tjbraham/modular-open-source-ptz-ai-cam-stack/Vision/Enclosure/Enclosure-assembled.stl

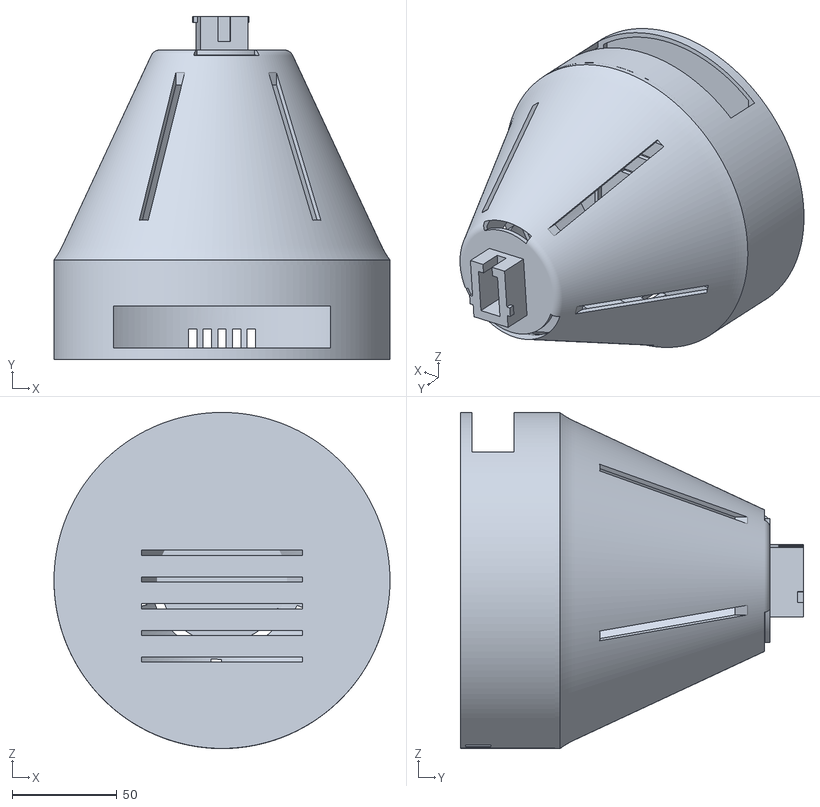
[picture p1: CAD file, 2026-06-19]
Vision/Enclosure/Enclosure-assembled.stl
160.0 x 163.5 x 160.1
