tjbraham/modular-open-source-ptz-ai-cam-stack/Power/Power_stack_PCB_stl/new_base.stl

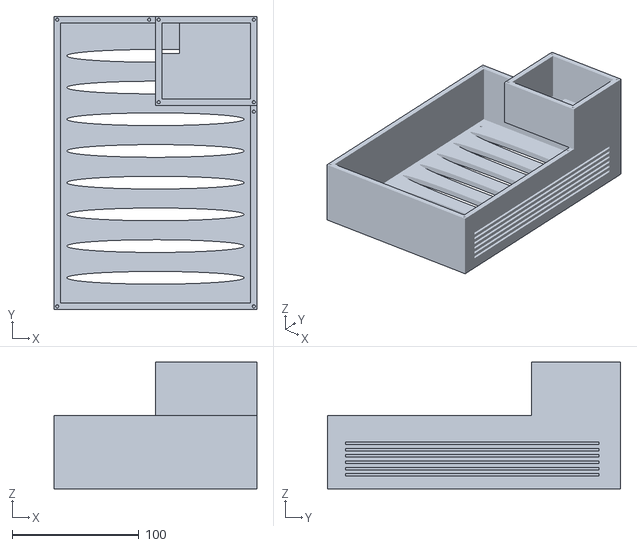
[picture p2: CAD file, 2026-06-20]
Power/Power_stack_PCB_stl/new_base.stl
160.0 x 231.0 x 100.0
