tjbraham/modular-open-source-ptz-ai-cam-stack/Vision/Motor-Brackets/Bottom-Bracket-Pan/Bottom-Bracket-Part-1.stl

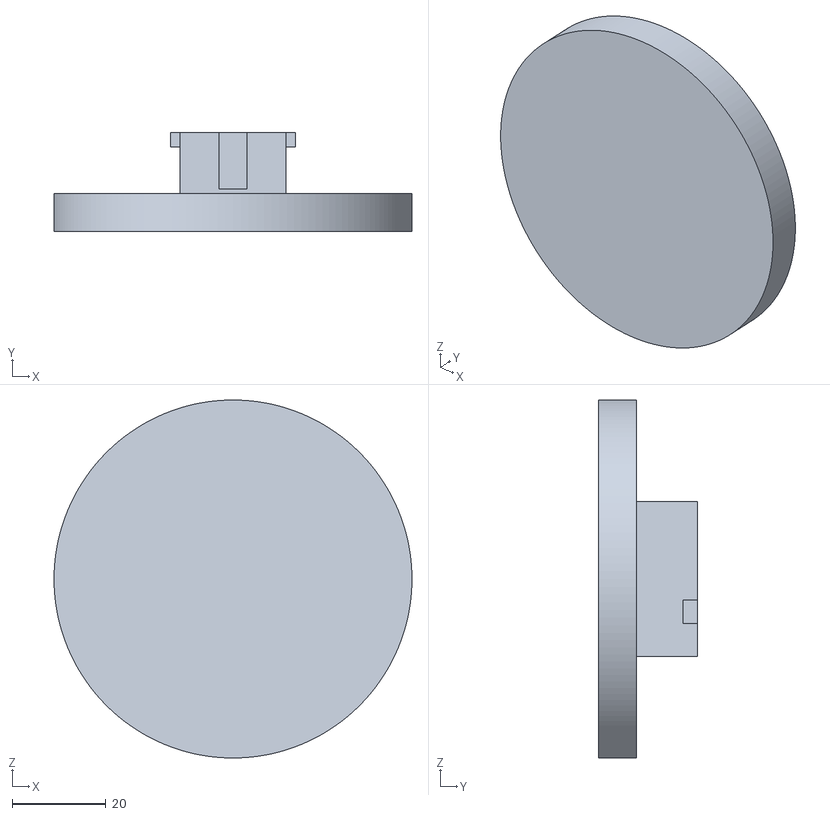
[picture p3: CAD file, 2026-06-19]
Vision/Motor-Brackets/Bottom-Bracket-Pan/Bottom-Bracket-Part-1.stl
76.2 x 21.0 x 76.2
