tjbraham/modular-open-source-ptz-ai-cam-stack/Vision/Motor-Brackets/Top-Bracket-Tilt/Top-Bracket-Part-1.stl

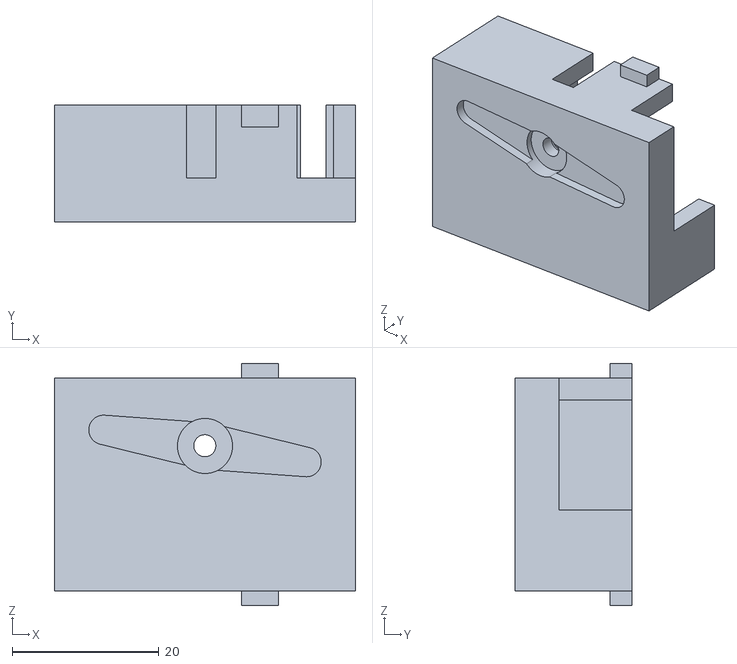
[picture p4: CAD file, 2026-06-19]
Vision/Motor-Brackets/Top-Bracket-Tilt/Top-Bracket-Part-1.stl
41.0 x 15.9 x 33.0
