tjbraham/modular-open-source-ptz-ai-cam-stack/Power/Power_stack_PCB_stl/PCB_holder_topSm.3mf

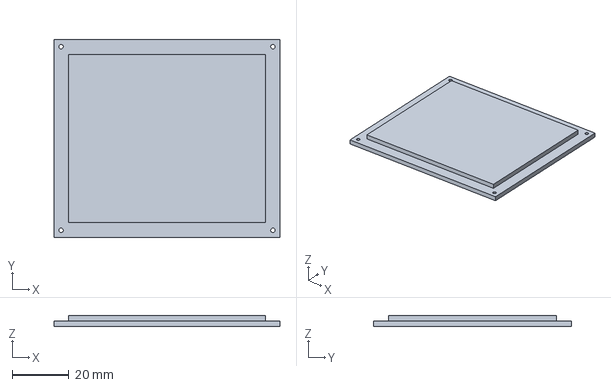
[picture p5: CAD file, 2026-06-20]
Power/Power_stack_PCB_stl/PCB_holder_topSm.3mf
80.0 x 70.0 x 4.00 mm
