tjbraham/modular-open-source-ptz-ai-cam-stack/Vision/Enclosure/Lid-enclosure.stl

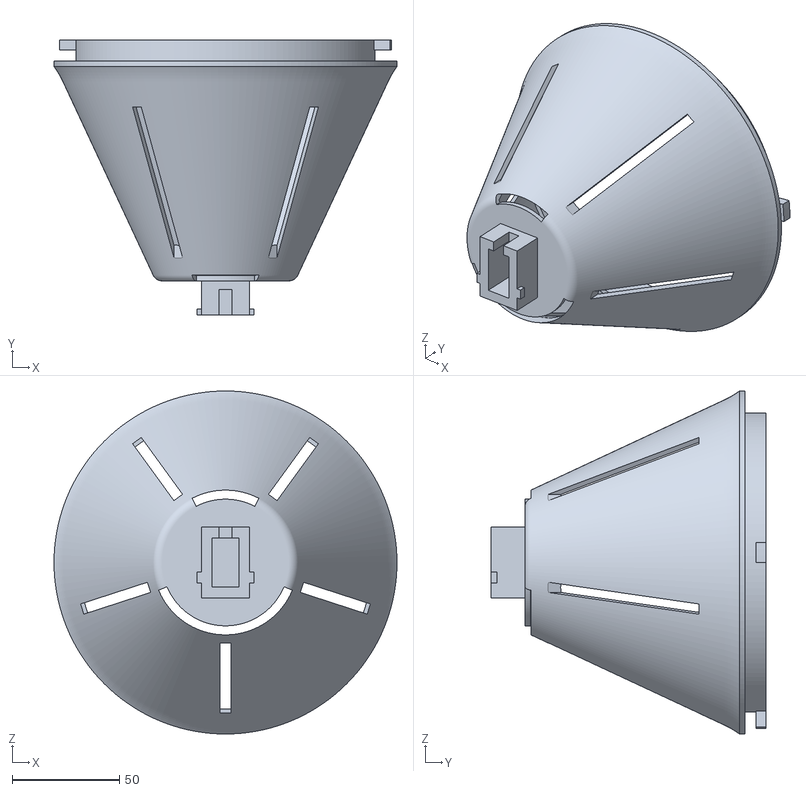
[picture p6: CAD file, 2026-06-19]
Vision/Enclosure/Lid-enclosure.stl
160.0 x 128.5 x 160.0
