tjbraham/modular-open-source-ptz-ai-cam-stack/Vision/Motor-Brackets/Bottom-Bracket-Pan/Bottom-Bracket-Part-2.stl

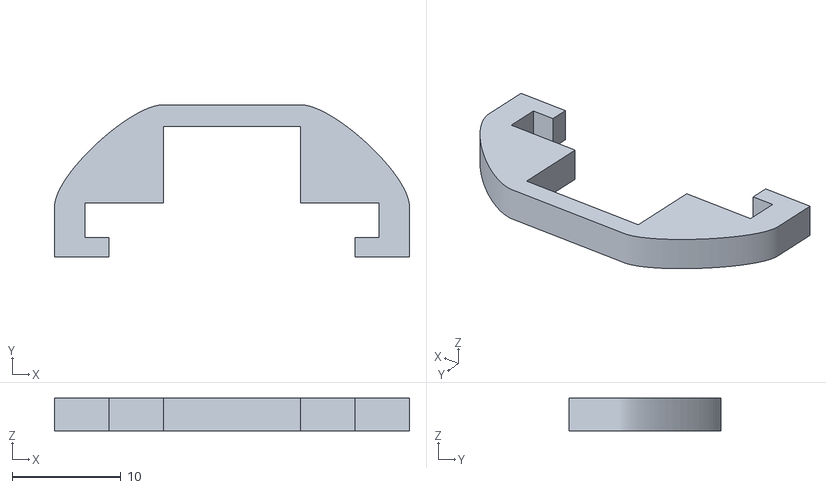
[picture p7: CAD file, 2026-06-19]
Vision/Motor-Brackets/Bottom-Bracket-Pan/Bottom-Bracket-Part-2.stl
32.6 x 14.0 x 3.00
