tjbraham/modular-open-source-ptz-ai-cam-stack/Vision/Motor-Brackets/Top-Bracket-Tilt/Top-Bracket-Part-2.stl

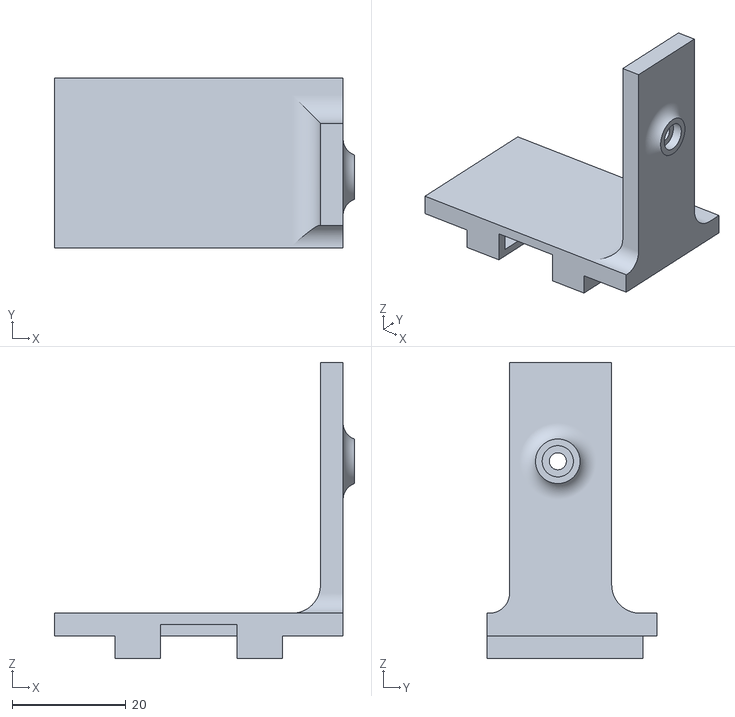
[picture p8: CAD file, 2026-06-19]
Vision/Motor-Brackets/Top-Bracket-Tilt/Top-Bracket-Part-2.stl
52.8 x 30.0 x 52.2
