tjbraham/modular-open-source-ptz-ai-cam-stack/Power/Power_stack_PCB_stl/new_PCB_holder_topL.3mf

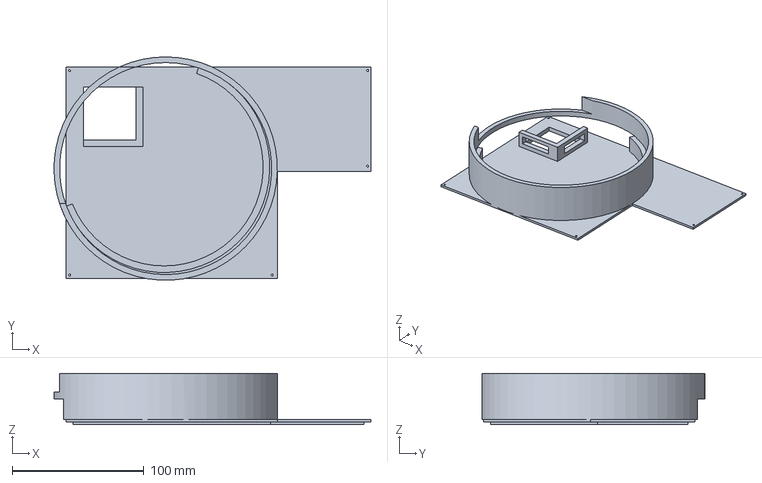
[picture p9: CAD file, 2026-06-20]
Power/Power_stack_PCB_stl/new_PCB_holder_topL.3mf
240.3 x 169.2 x 39.0 mm
