tjbraham/modular-open-source-ptz-ai-cam-stack/Vision/Enclosure/Bottom-enclosure.stl

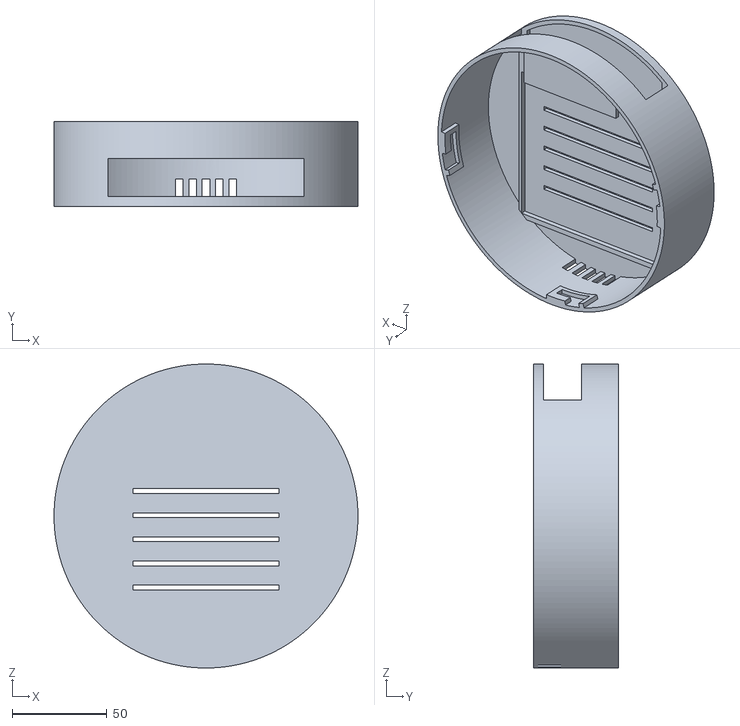
[picture p10: CAD file, 2026-06-19]
Vision/Enclosure/Bottom-enclosure.stl
160.0 x 45.0 x 160.0
