tjbraham/modular-open-source-ptz-ai-cam-stack/Vision/Motor-Brackets/Top-Bracket-Tilt/Top-Bracket-Part-3.stl

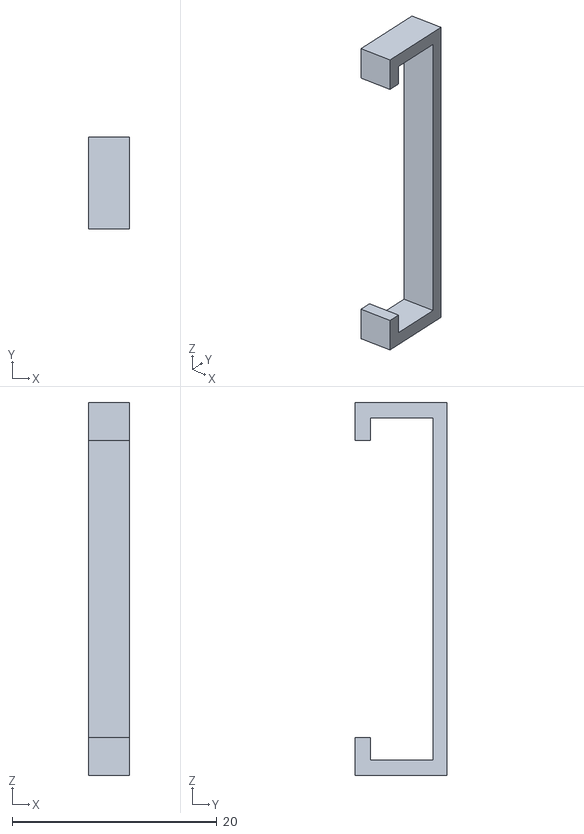
[picture p11: CAD file, 2026-06-19]
Vision/Motor-Brackets/Top-Bracket-Tilt/Top-Bracket-Part-3.stl
4.00 x 9.00 x 36.4
