tjbraham/modular-open-source-ptz-ai-cam-stack/Power/Power_stack_PCB_stl/PCB_holder_base.3mf

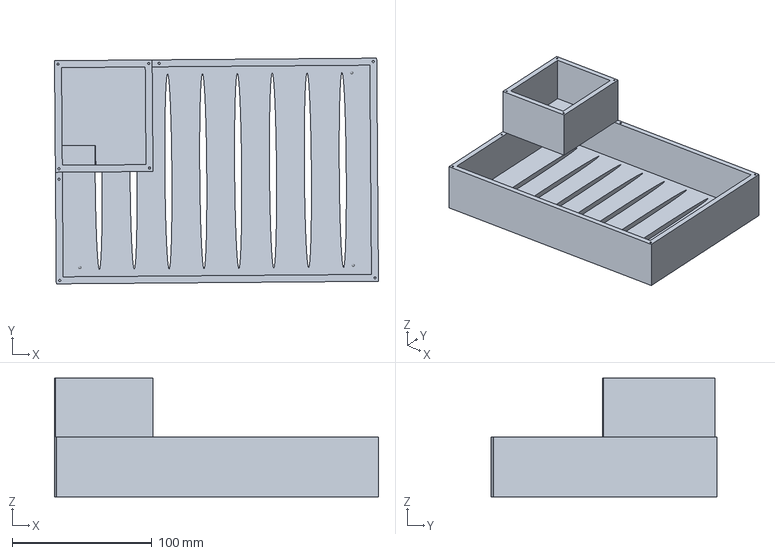
[picture p12: CAD file, 2026-06-20]
Power/Power_stack_PCB_stl/PCB_holder_base.3mf
232.3 x 161.8 x 85.0 mm
