tjbraham/modular-open-source-ptz-ai-cam-stack/(list of files, cad)

Other CAD files:
Power/Power_stack_PCB_stl/PCB_holder_base.stl
Power/Power_stack_PCB_stl/PCB_holder_topSm.stl
Power/Power_stack_PCB_stl/new_PCB_holder_topL.stl
