tjbraham/modular-open-source-ptz-ai-cam-stack/Power/PCB_files/GA8ED_Capstone_revised.kicad_pcb

## KiCad design Power/PCB_files/GA8ED_Capstone_revised.kicad_pcb (2026-06-20)

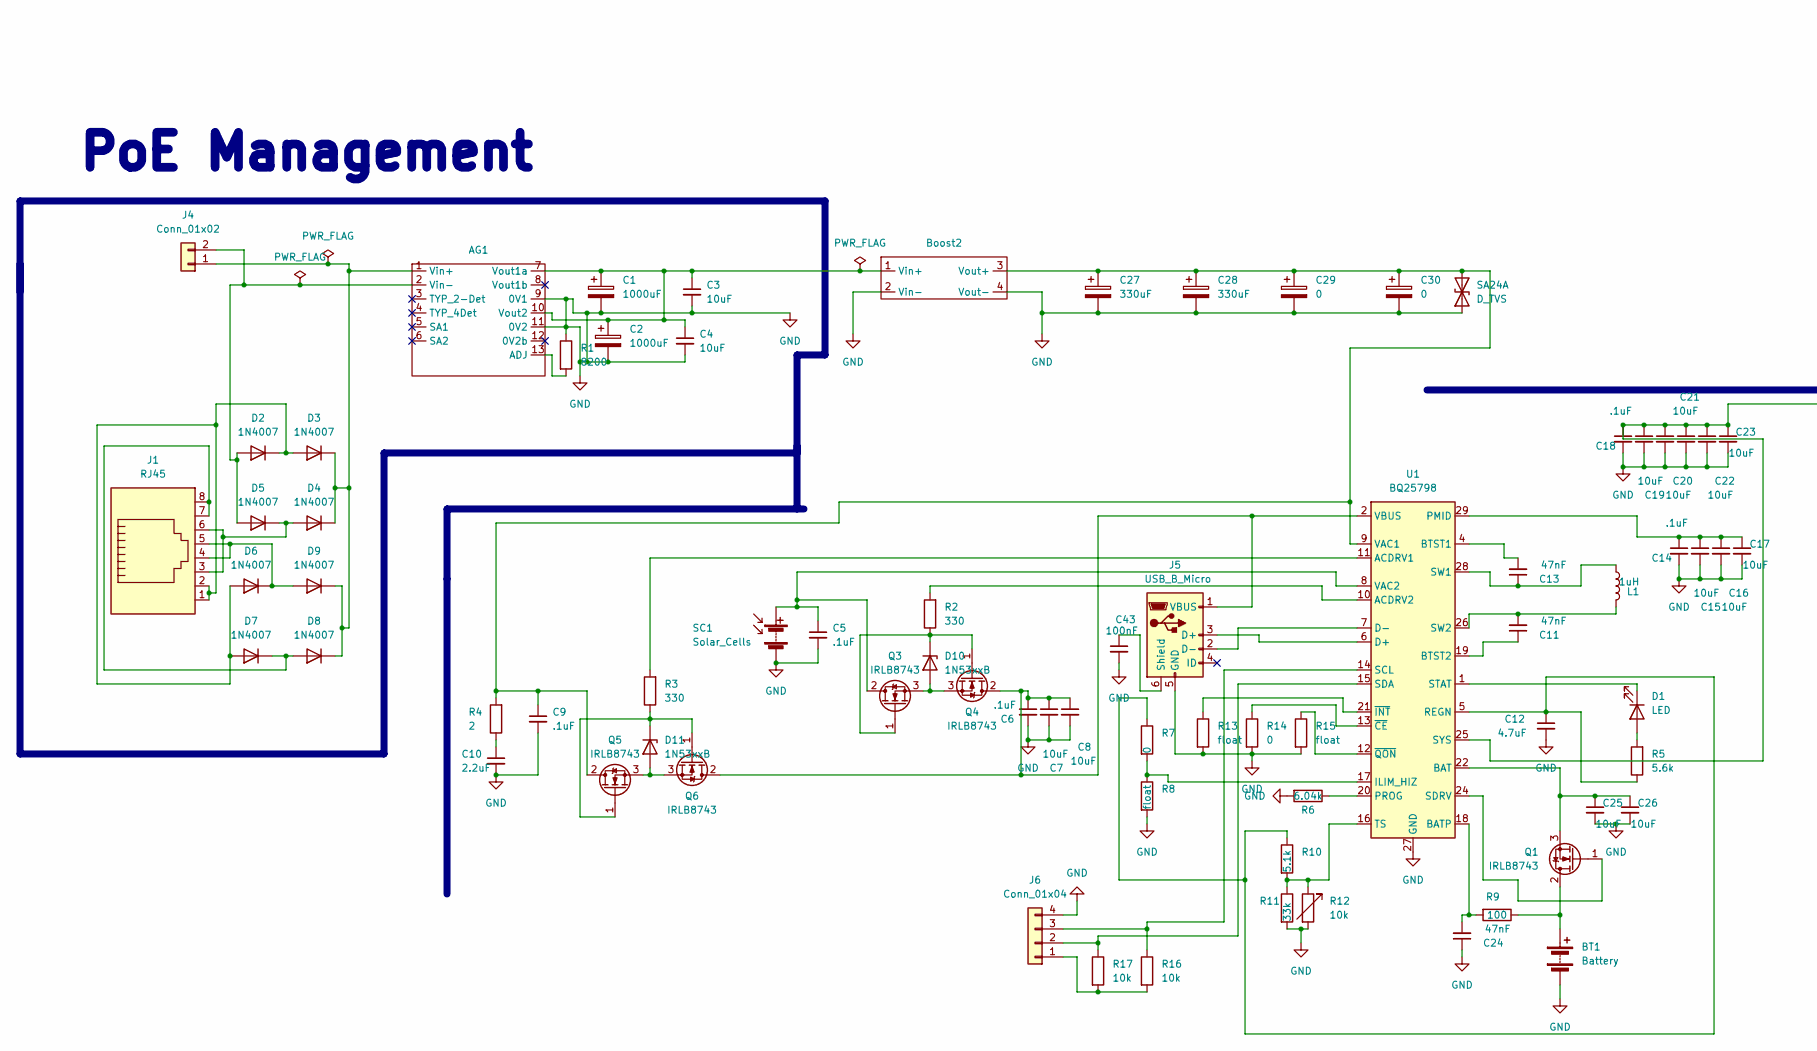
[picture p13: schematic GA8ED_Capstone_revised.kicad_sch, part in row 1, column 1]

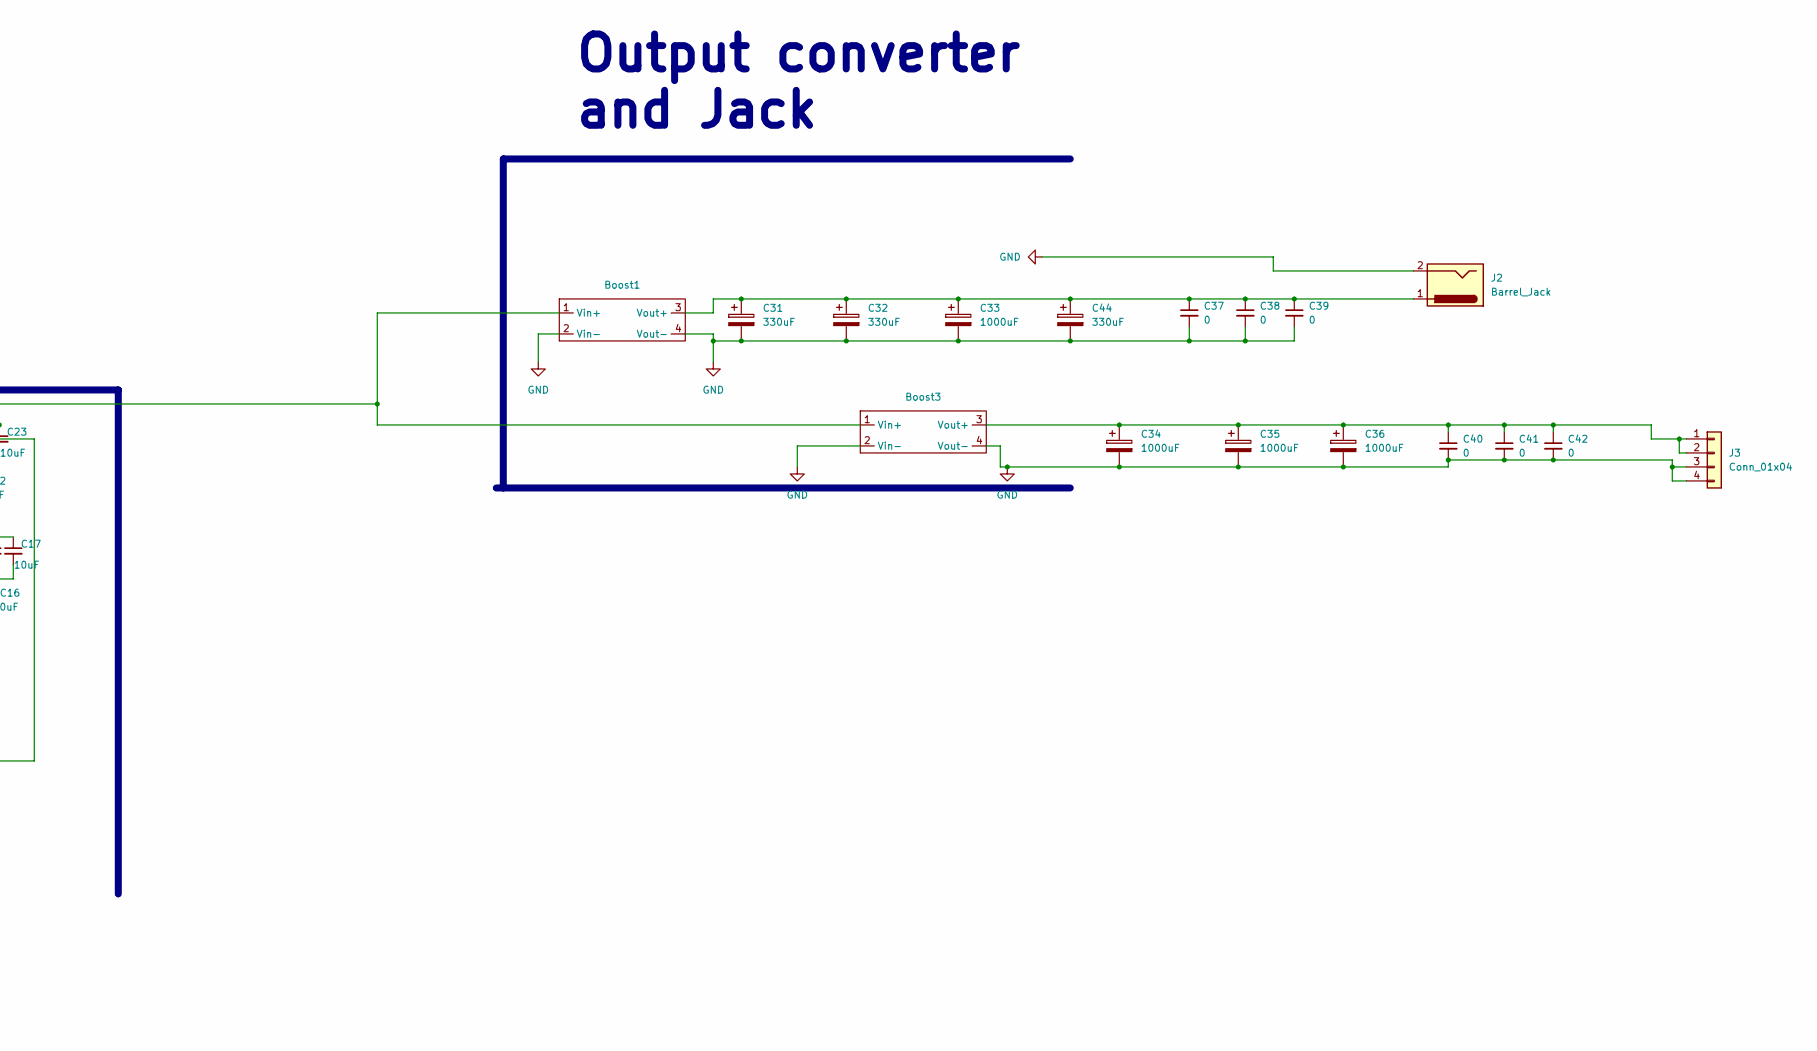
[picture p14: schematic GA8ED_Capstone_revised.kicad_sch, part in row 1, column 2]

Parts:
AG1: Converter_DCDC_Silvertel_Ag5810
BT1: Battery; TerminalBlock_Xinya_XY308-2.54-2P_1x02_P2.54mm_Horizontal
Boost1, Boost2: boost_1
Boost3: buck1
C1, C2, C33, C34, C35, C36: 1000uF; CP_Radial_D14.0mm_P5.00mm
C3, C4, C7, C8, C15, C16, C17, C19, C20, C21, C22, C23, C25, C26: 10uF; C_Disc_D5.0mm_W2.5mm_P5.00mm
C5, C6, C9, C14, C18: .1uF; C_Disc_D5.0mm_W2.5mm_P5.00mm
C10: 2.2uF; C_Disc_D5.0mm_W2.5mm_P5.00mm
C11, C13, C24: 47nF; C_Disc_D5.0mm_W2.5mm_P5.00mm
C12: 4.7uF; C_Disc_D5.0mm_W2.5mm_P5.00mm
C27, C28, C31, C32, C44: 330uF; CP_Radial_D14.0mm_P5.00mm
C29, C30, C37, C38, C39, C40, C41, C42: 0; C_Disc_D5.0mm_W2.5mm_P5.00mm
C43: 100nF; C_Disc_D5.0mm_W2.5mm_P5.00mm
D1: LED; LED_D5.0mm_IRBlack
D2, D3, D4, D5, D6, D7, D8, D9: 1N4007; D_DO-41_SOD81_P10.16mm_Horizontal
D10, D11: 1N53xxB; D_DO-201_P15.24mm_Horizontal
J1: RJ45; PinHeader_1x08_P2.54mm_Horizontal
J2: Barrel_Jack; TerminalBlock_MaiXu_MX126-5.0-02P_1x02_P5.00mm
J3, J6: Conn_01x04; PinHeader_1x04_P2.54mm_Horizontal
J4: Conn_01x02; PinSocket_1x02_P2.54mm_Horizontal
J5: USB_B_Micro; USB_Micro-B_Amphenol_10103594-0001LF_Horizontal
L1: 1uH; L_Radial_D16.8mm_P12.07mm_Vishay_IHB-1
Q1, Q3, Q4, Q5, Q6: IRLB8743; TO-220-3_Vertical
R1: 8200; R_Axial_DIN0207_L6.3mm_D2.5mm_P7.62mm_Horizontal
R2, R3: 330; R_Axial_DIN0207_L6.3mm_D2.5mm_P7.62mm_Horizontal
R4: 2; R_Axial_DIN0207_L6.3mm_D2.5mm_P7.62mm_Horizontal
R5: 5.6k; R_Axial_DIN0207_L6.3mm_D2.5mm_P7.62mm_Horizontal
R6: 6.04k; R_Axial_DIN0207_L6.3mm_D2.5mm_P7.62mm_Horizontal
R7, R14: 0; R_Axial_DIN0207_L6.3mm_D2.5mm_P7.62mm_Horizontal
R8, R13, R15: float; R_Axial_DIN0207_L6.3mm_D2.5mm_P7.62mm_Horizontal
R9: 100; R_Axial_DIN0207_L6.3mm_D2.5mm_P7.62mm_Horizontal
R10: 5.1k; R_Axial_DIN0207_L6.3mm_D2.5mm_P7.62mm_Horizontal
R11: 33k; R_Axial_DIN0207_L6.3mm_D2.5mm_P7.62mm_Horizontal
R12, R16, R17: 10k; R_Axial_DIN0207_L6.3mm_D2.5mm_P7.62mm_Horizontal
SA24A: D_TVS
SC1: Solar_Cells; TerminalBlock_MaiXu_MX126-5.0-02P_1x02_P5.00mm
U1: BQ25798; Texas_RQM0029A_VQFN-29_4x4mm_P0.4mm

Connections:
GND: AG1.9 (0V1), AG1.11 (0V2), BT1.2 (-), Boost1.2 (Vin-), Boost1.4 (Vout-), Boost2.2 (Vin-), Boost2.4 (Vout-), Boost3.2 (Vin-), Boost3.4 (Vout-), C1.2, C2.2, C3.2, C4.2, C5.2, C6.2, C7.2, C8.2, C9.2, C10.2, C12.2, C14.2, C15.2, C16.2, C17.2, C18.2, C19.2, C20.2, C21.2, C22.2, C23.2, C24.1, C25.2, C26.2, C27.2, C28.2, C29.2, C30.2, C31.2, C32.2, C33.2, C34.2, C35.2, C36.2, C37.2, C38.2, C39.2, C40.2, C41.2, C42.2, C43.2, C44.2, J2.2, J3.3, J3.4, J5.5 (GND), J6.4, R1.1, R6.2, R8.2, R11.2, R12.2, R13.2, R14.2, R15.2, SA24A.1 (A1), SC1.2 (-), U1.27 (GND)
unnamed: AG1.13 (ADJ), R1.2
unnamed: AG1.1 (Vin+), D3.1 (K), D4.1 (K), D8.1 (K), D9.1 (K), J4.1
unnamed: AG1.2 (Vin-), D2.2 (A), D5.2 (A), J4.2
unnamed: AG1.7 (Vout1a), AG1.10 (Vout2), Boost2.1 (Vin+), C1.1, C2.1, C3.1, C4.1
unnamed: BT1.1 (+), Q1.2 (D), R9.1
unnamed: Boost1.1 (Vin+), Boost3.1 (Vin+), C18.1, C19.1, C20.1, C21.1, C22.1, C23.1, U1.25 (SYS)
unnamed: Boost1.3 (Vout+), C31.1, C32.1, C33.1, C37.1, C38.1, C39.1, C44.1, J2.1
unnamed: Boost2.3 (Vout+), C9.1, C27.1, C28.1, C29.1, C30.1, Q5.2 (D), R4.2, SA24A.2 (A2), U1.9 (VAC1)
unnamed: Boost3.3 (Vout+), C34.1, C35.1, C36.1, C40.1, C41.1, C42.1, J3.1, J3.2
unnamed: C10.1, R4.1
unnamed: D1.2 (A), R5.2
unnamed: D1.1 (K), U1.1 (STAT)
unnamed: D2.1 (K), D3.2 (A), D6.2 (A), D7.2 (A), J1.1, J1.2
unnamed: D4.2 (A), D5.1 (K), J1.3, J1.6
unnamed: D6.1 (K), D9.2 (A), J1.4, J1.5
unnamed: D7.1 (K), D8.2 (A), J1.7, J1.8
unnamed: D10.2 (A), Q3.3 (S), Q4.3 (S)
unnamed: D10.1 (K), Q3.1 (G), Q4.1 (G), R2.1
unnamed: D11.2 (A), Q5.3 (S), Q6.3 (S)
unnamed: D11.1 (K), Q5.1 (G), Q6.1 (G), R3.1
unnamed: J5.3 (D+), U1.6 (D+)
unnamed: J5.2 (D-), U1.7 (D-)
unnamed: C43.1, J5.6 (Shield)
unnamed: C6.1, C7.1, C8.1, J5.1 (VBUS), Q4.2 (D), Q6.2 (D), U1.2 (VBUS), U1.3 (VBUS)
unnamed: J6.1, R16.2, R17.2
unnamed: J6.2, R17.1, U1.15 (SDA)
unnamed: J6.3, R16.1, U1.14 (SCL)
unnamed: Q1.1 (G), U1.24 (SDRV)
unnamed: C25.1, C26.1, Q1.3 (S), U1.22 (BAT), U1.23 (BAT)
unnamed: C5.1, Q3.2 (D), SC1.1 (+), U1.8 (VAC2)
unnamed: R3.2, U1.11 (ACDRV1)
unnamed: R2.2, U1.10 (ACDRV2)
unnamed: C24.2, R9.2, U1.18 (BATP)
unnamed: C13.2, U1.4 (BTST1)
unnamed: C11.1, U1.19 (BTST2)
unnamed: R7.2, R8.1, U1.17 (ILIM_HIZ)
unnamed: C14.1, C15.1, C16.1, C17.1, U1.29 (PMID)
unnamed: R6.1, U1.20 (PROG)
unnamed: C12.1, R5.1, R7.1, R10.1, U1.5 (REGN)
unnamed: C13.1, L1.1, U1.28 (SW1)
unnamed: C11.2, L1.2, U1.26 (SW2)
unnamed: R10.2, R11.1, R12.1, U1.16 (TS)
unnamed: R14.1, U1.13 (~CE)
unnamed: R13.1, U1.21 (~INT)
unnamed: R15.1, U1.12 (~QON)

Notes on the sheet:
Output converter and Jack
PoE Management

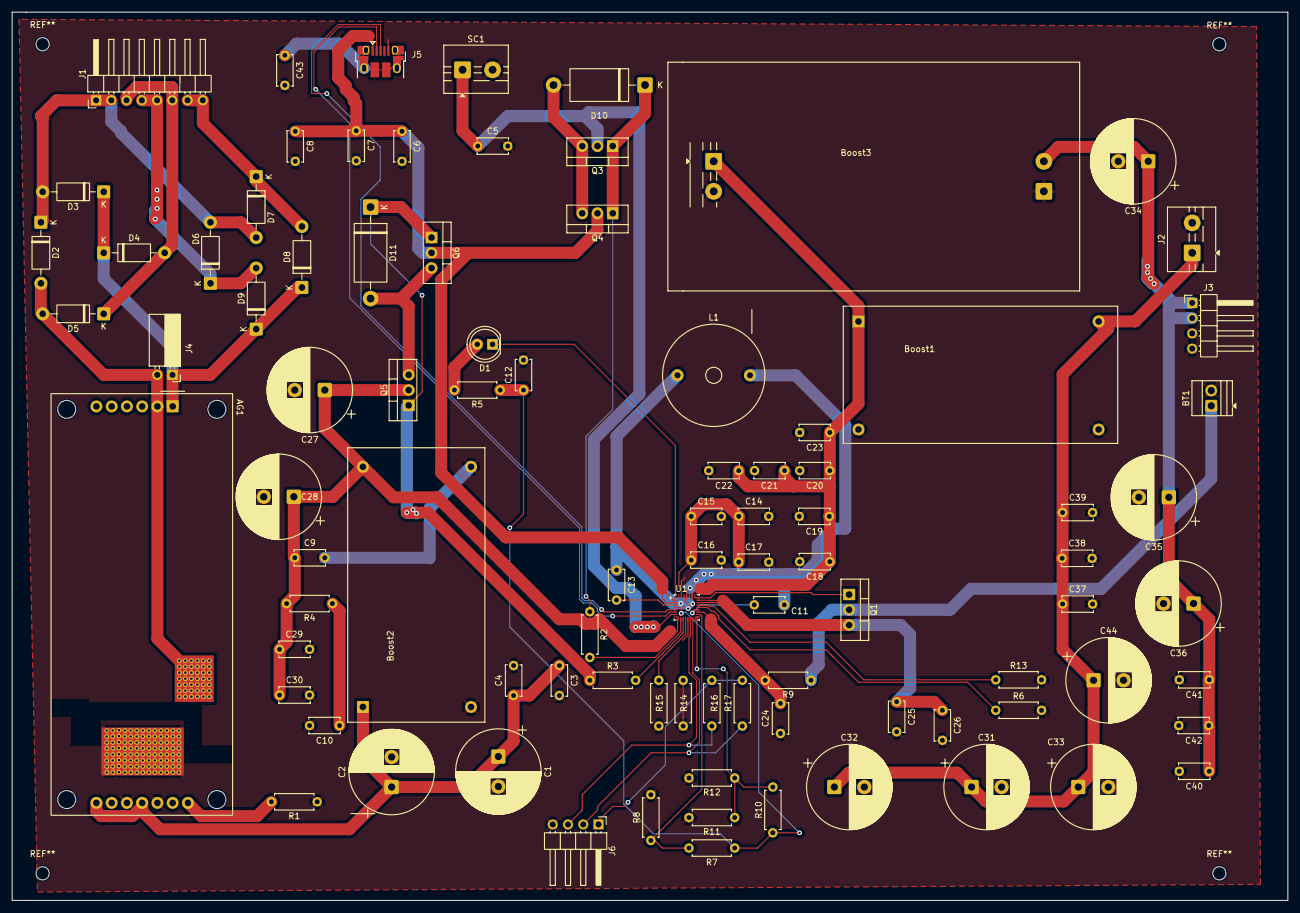
[picture p15: board GA8ED_Capstone_revised.kicad_pcb from above]

Board: 2 copper layers, 212.5 x 148.0 mm, 91 parts (0 on the bottom side), 46 nets.
