tjbraham/modular-open-source-ptz-ai-cam-stack/Vision/Motor-Brackets/Bracket-assembled-drawing.png

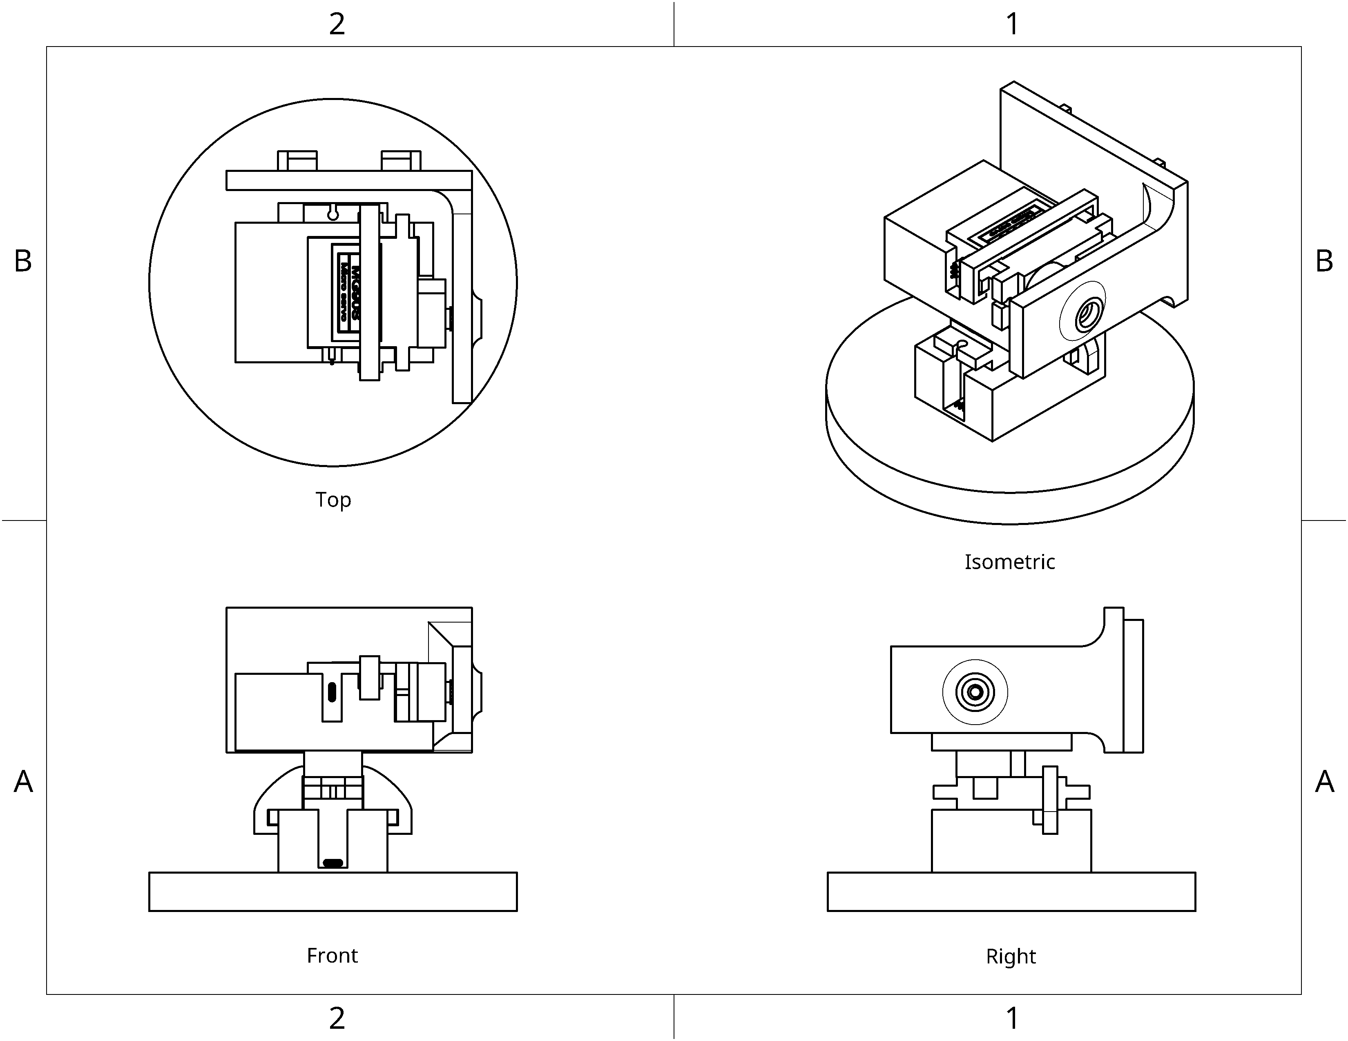
Vision/Motor-Brackets/Bracket-assembled-drawing.png
