tjbraham/modular-open-source-ptz-ai-cam-stack/(commit log)

2026-06-02 Add overview and LTE integration documentation
    Document the design and implementation of a modular open-source PTZ AI camera platform with LTE integration.
2026-06-19 uploaded all stl files for brackets and enclosure
    [Bottom Bracket and holder - Part 1.stl, Bottom Bracket and holder - Part 2.stl, Bottom enclosure.stl, Lid enclosure.stl, top motor holder - Part 2.stl, top motor holder - Part 3.stl, top motor holder - Part 4.stl]
2026-06-19 Added readme for overall, bracket, and enclosure. uploaded correct stl files and png of drawing for the brackets.
    [Bottom Bracket and holder - Part 1.stl, Bottom Bracket and holder - Part 2.stl, Bottom enclosure.stl, Enclosure assembled.stl, Lid enclosure.stl, top motor holder - Part 2.stl, top motor holder - Part 3.stl, top motor holder - Part 4.stl]
2026-06-20 reanme folder
    [Top-Bracket-Part-1.stl, Top-Bracket-Part-2.stl, Top-Bracket-Part-3.stl]
2026-06-20 rename more
    [Bottom-Bracket-Part-1.stl, Bottom-Bracket-Part-2.stl]
2026-06-20 rename big folder
    [Bottom-Bracket-Part-1.stl, Bottom-Bracket-Part-2.stl, Top-Bracket-Part-1.stl, Top-Bracket-Part-2.stl, Top-Bracket-Part-3.stl]
2026-06-20 rename and readme for brackets
    [Bottom-Bracket-Part-1.stl, Bottom-Bracket-Part-2.stl, Top-Bracket-Part-1.stl, Top-Bracket-Part-2.stl, Top-Bracket-Part-3.stl]
2026-06-20 rename and add motor controller folder and readme
    [Bottom-Bracket-Part-1.stl, Bottom-Bracket-Part-2.stl, Top-Bracket-Part-1.stl, Top-Bracket-Part-2.stl, Top-Bracket-Part-3.stl]
2026-06-20 rename power folder
    [GA8ED_Capstone_revised.kicad_pcb, GA8ED_Capstone_revised.kicad_sch, PCB_holder_base.3mf, PCB_holder_base.stl, PCB_holder_topSm.3mf, PCB_holder_topSm.stl, new_PCB_holder_topL.3mf, new_PCB_holder_topL.stl]
2026-06-20 rename power readme to display on page
2026-06-20 updates readme for motor controller and overall to include info about software pipeline and motor assembly
2026-06-20 Fix links for Motor-Brackets and Enclosure sections
    Updated links in the README to point to specific README files in directories.
2026-06-20 Fix links to Motor-Brackets and Enclosure directories
2026-06-20 Update link to Motor-Brackets directory in README
2026-06-20 Fix link to Motor-Brackets directory in README
    Updated the link to the Motor-Brackets directory in the README.
